Che-Peter/IncubatorProject/Images/3d_back_for_main_PCB.png

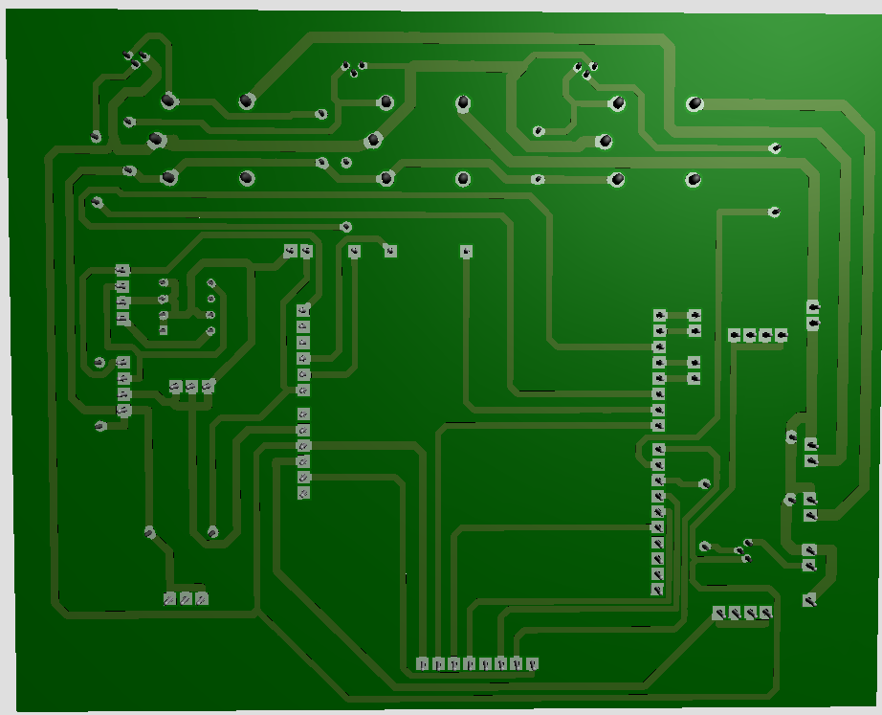
Images/3d_back_for_main_PCB.png
