Che-Peter/IncubatorProject/Images/3D_front_for_main_PCB.png

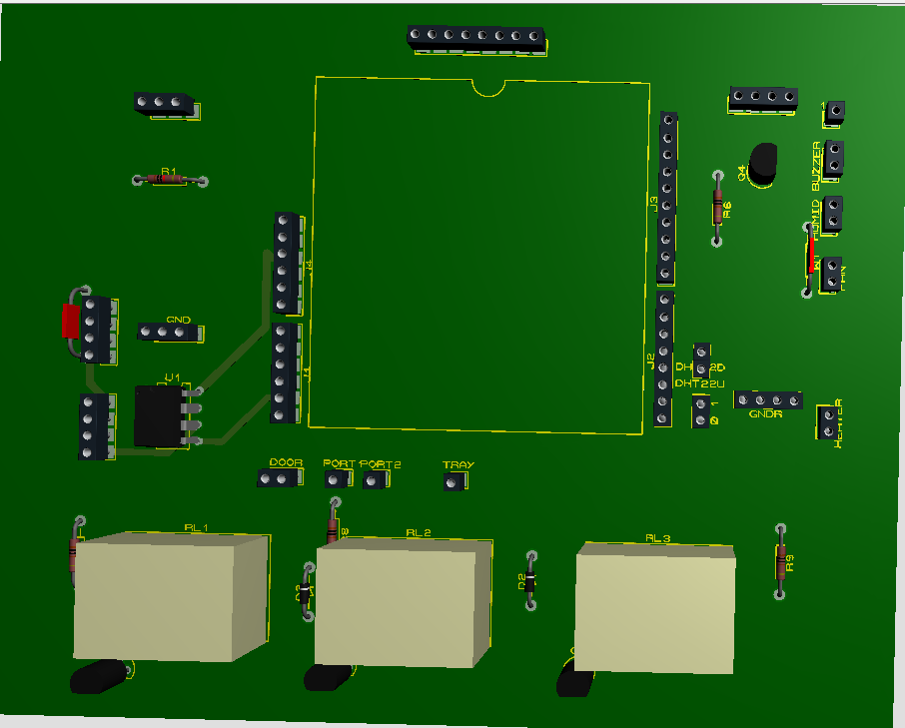
Images/3D_front_for_main_PCB.png
