Che-Peter/IncubatorProject/Images/data_record_day_2.png

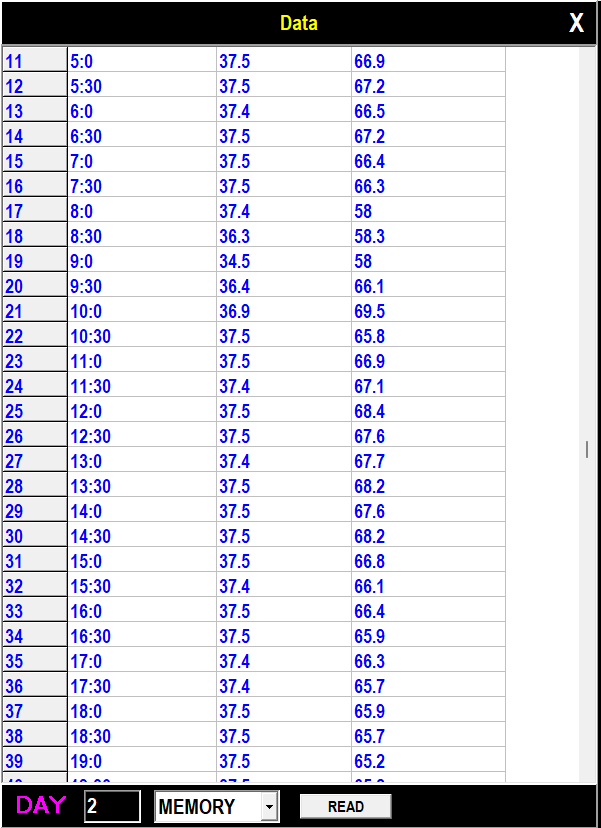
Images/data_record_day_2.png
