Che-Peter/IncubatorProject/Images/Egg_settings_for_my_incubator.png

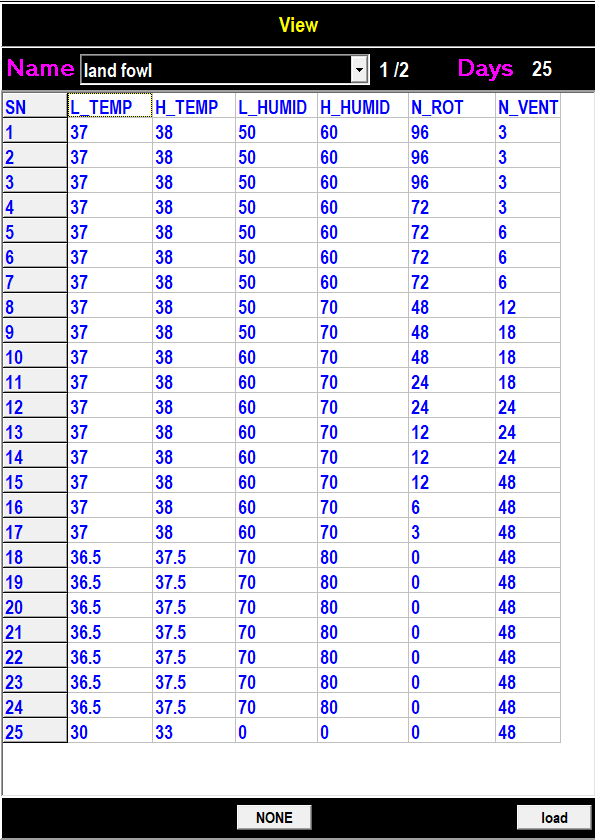
Images/Egg_settings_for_my_incubator.png
