Che-Peter/IncubatorProject/Images/internal_view_with_fan_and_humidifier.jpg

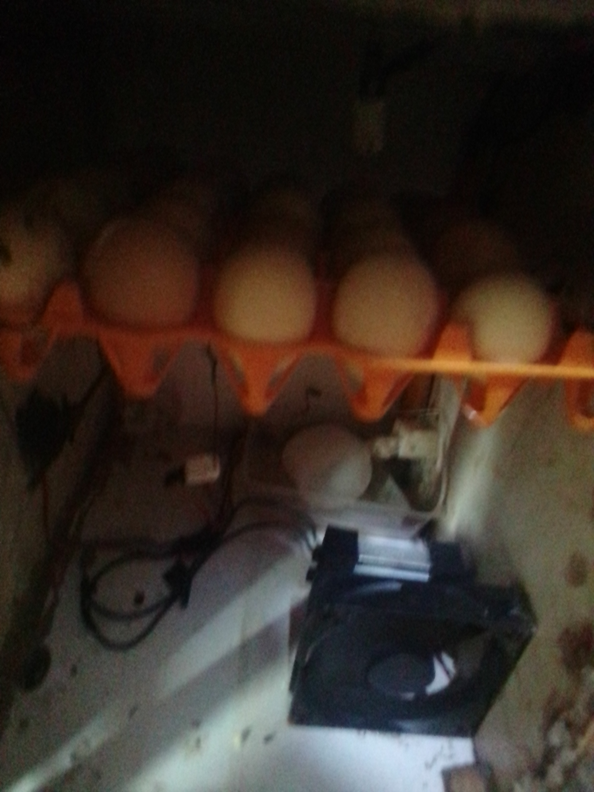
Images/internal_view_with_fan_and_humidifier.jpg
