Che-Peter/IncubatorProject/Images/schematic_power_changeover.png

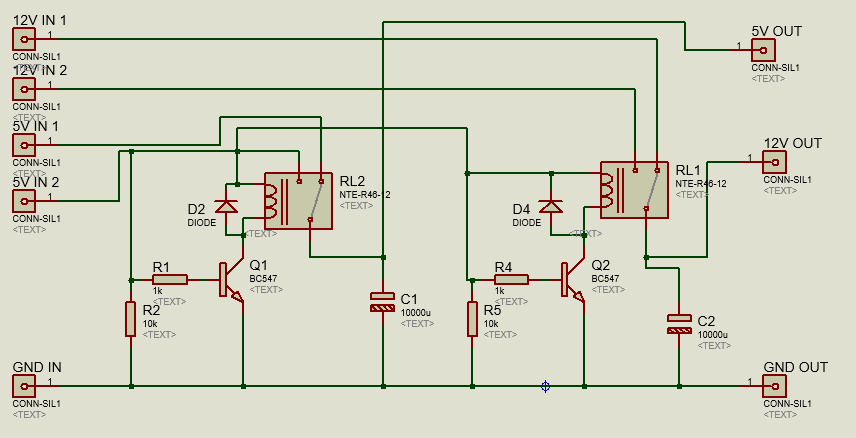
Images/schematic_power_changeover.png
