Che-Peter/IncubatorProject/Images/setting_days.jpg

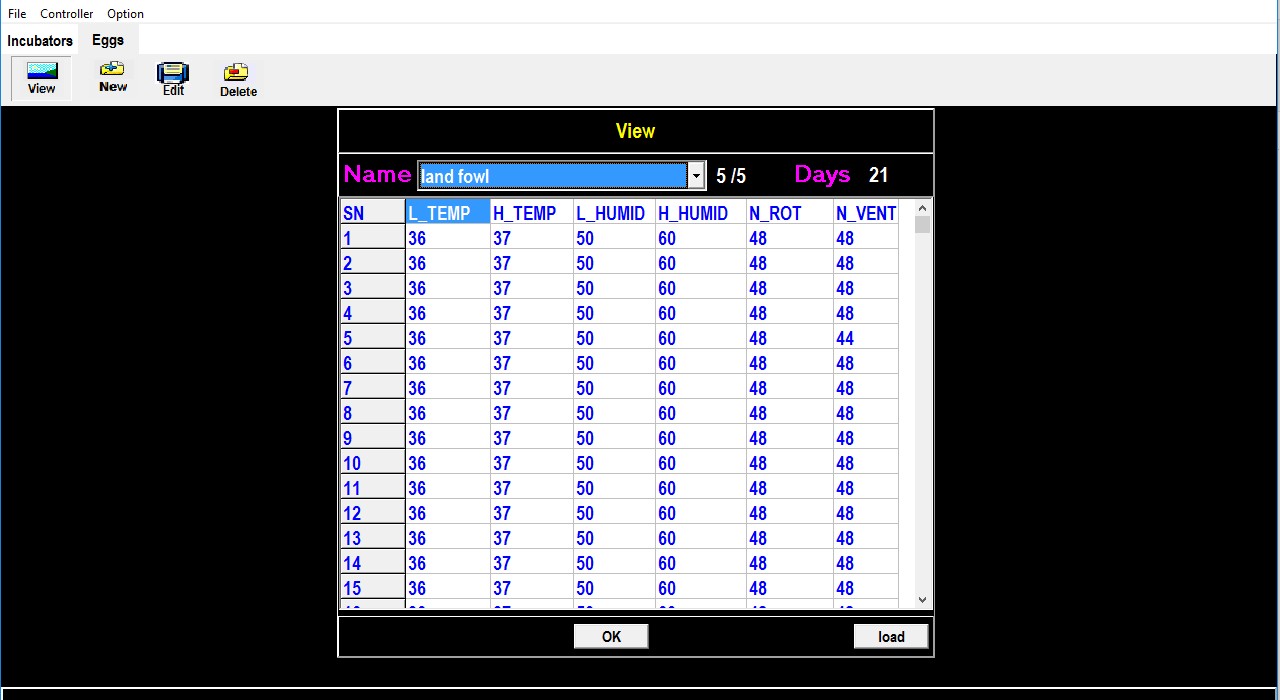
Images/setting_days.jpg
