Che-Peter/IncubatorProject/Images/signing.png

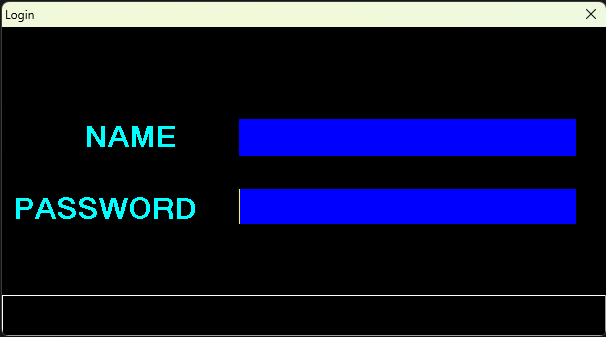
Images/signing.png
