Che-Peter/IncubatorProject/Estimate/cost_breakdown.pdf

## Estimate for incubator automation

SN | ITEM | SPECIFICATION | QTY | UNIT PRICE (FCFA) | COST PRICE (FCFA)
1 | DC fan | 12 V | 2 | 1,500 | 3,000
2 | Dht22 | Temperature and humidity | 4 | 3,500 | 14,000
3 | DC Heaters | 100 w | 1 | 10,000 | 10,000
4 | DC HEATER | 10W | 1 | 4,000 | 4,000
5 | RTC | DS3231 | 1 | 2,500 | 2,500
6 | LCD | 16 x 2 I2C | 1 | 2,500 | 2,500
7 | microcontroller | Arduino MEGA | 1 | 12,000 | 12,000
8 | Diodes | 1N4001 | 2 | 100 | 200
9 | Capacitor | 1000uf, 16v, polarized | 1 | 200 | 200
10 | BJT Transistor | BC547 | 4 | 100 | 400
11 | Resistor | 1k | 4 | 50 | 200
12 | Resistor | 10k | 7 | 50 | 350
13 | LED | Red and green | 2 | 25 | 50
14 | Resistor | 220R | 2 | 50 | 100
15 | buttons | Tactile buttons | 3 | 200 | 600
16 | MOSFET | IRFZ44N | 4 | 500 | 2000
17 | Cables | Ethernet cables(500) | 1 | 500 | 500
18 | DC cables(m) | Stranded wire (x/m) | 2 | 1,500 | 3,000
19 | Buzzer | 3v-12v buzzer | 1 | 500 | 500
20 | Lead (m) | Soldering lead (x/m) | 4 | 150 | 600
21 | Connectors | Male to female | 10 | 1,000 | 10,000
22 | Gear motor | 12v | 1 | 5,000 | 5,000
23 | Servo | Large but 5v | 2 | 2,500 | 5,000
24 | Rod and screw | For rotation | 1 | 2,500 | 2,500
25 | Gums | White sticks | 3 | 300 | 900
26 | Limit switch | For rotation | 3 | 1,300 | 3,900
27 | Water tray | As humidifier | 1 | 1,000 | 1,000
28 | cable | Female to male connectors | 40 | 50 | 2000
29 | PCB | Boar and circuit | 1 | 4,000 | 4,000
29 | RF module | NRF24L01 | 1 | 4,000 | 4,000
TOTAL | | | | | 95,000

Estimate for computer connected module

SN | ITEM | SPECIFICATION | QTY | UNIT PRICE (FCFA) | COST PRICE (FCFA)
1 | Nrf24l01 | | 1 | 4,000 | 4,000
2 | Microcontroller | Arduino Nano | 1 | 4,000 | 4,000
3 | Cable | Male to female | 6 | 50 | 300
4 | Casing | Gums plus material | 1 | 2,500 | 2,500
TOTAL | | | | | 10,800

Estimate for power supply

SN | Item | Specification | QTY | Unit Price (FCFA) | Cost price (FCFA)
1 | Buck converter | 12V to 5V | 1 | 2,500 | 2,500
2 | AC/DC adapter | 220 to 5v, 2A | 1 | 2,000 | 2,000
3 | AC/DC adapter | 220 to 12v, 20A | 1 | 8,000 | 8,000
TOTAL | | | | | 12,500

Estimate for power conversion unit

SN | Item | Specification | Quantity | Unit Price (FCFA) | Cost price (FCFA)
1 | Relay | 5 v relay | 2 | 500 | 1000
2 | capacitor | 1000uF at 16 v | 2 | 500 | 1000
3 | resistor | 2x1k and 2x10k | 4 | 100 | 400
4 | transistor | BC547 | 2 | 200 | 400
5 | diode | IN4007 | 2 | 100 | 200
6 | connectors | Male heads | 8 | 50 | 400
7 | PCB | 1/4 board, acid, drilling | 1 | 2,000 | 2,000
8 | Lead | Soldering lead | 1 | 150 | 150
TOTAL | | | | | 5,550
