Che-Peter/IncubatorProject/(list of files, drawings)

Other design files:
Schematics/main circuit schematic and pcb.pdsprj
Schematics/power selection schematic and pcb.pdsprj
