Che-Peter/IncubatorProject/Images/first_run_test.jpg

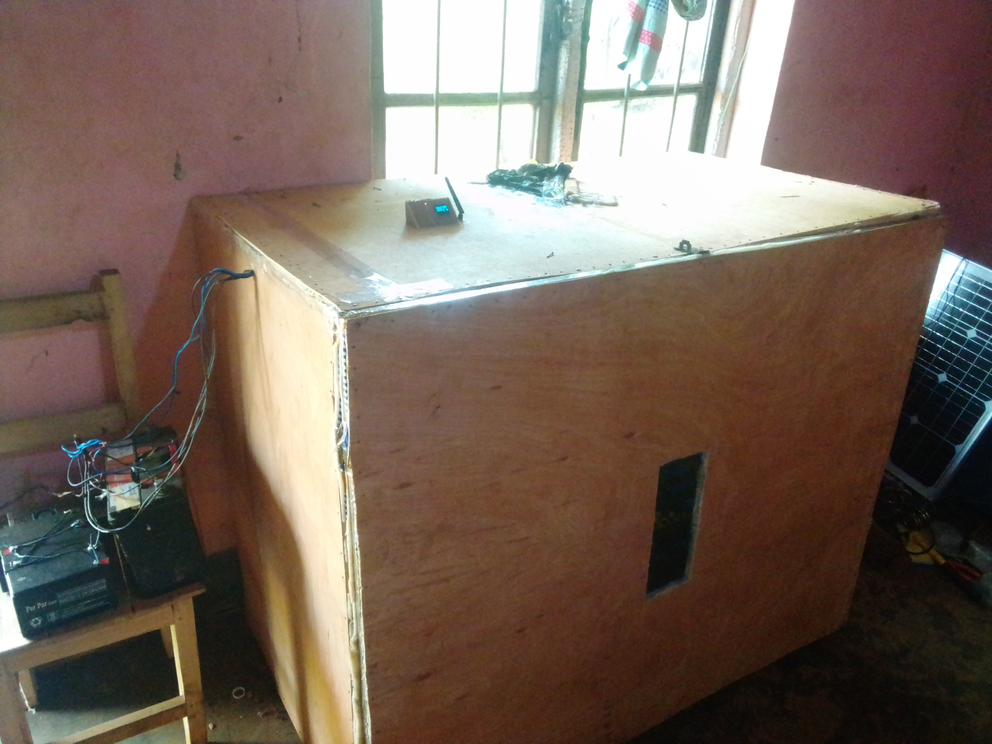
Images/first_run_test.jpg
