Che-Peter/IncubatorProject/(commit log)

2026-05-12 Update README.md
    Extended Description (Summary)
    This project began as a 30‑egg prototype incubator where I faced real challenges in power reliability, sensor stability, and wireless communication. Debugging taught me resilience and the difference between quick prototypes and real‑world products.
    Scaling the design to 1,200 eggs required stronger PCB design, better airflow management, and more reliable converters. The result was not only successful hatch rates but also valuable data collection that demonstrated environmental stability at scale.
    This repository captures both the **engineering journey** and the **practical outcomes** — from schematics and code to real hatch s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
2026-05-12 Rename 3D front for main PCB.png to 3D_front_for_main_PCB.png
2026-05-12 Rename internal view with fan and humidifier.jpg to internal_view_with_fan_and_humidifier.jpg
